westonb/ionophoney/simulation/resonator/testing/test1/84w_1.bmp

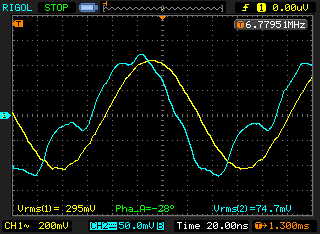
simulation/resonator/testing/test1/84w_1.bmp
