westonb/ionophoney/simulation/resonator/testing/test1/84w_2.bmp

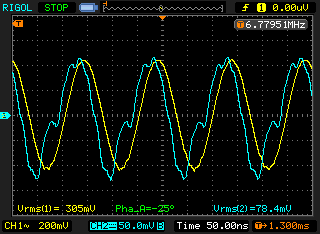
simulation/resonator/testing/test1/84w_2.bmp
