westonb/ionophoney/simulation/resonator/testing/test1/120w_2.bmp

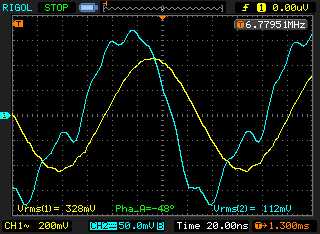
simulation/resonator/testing/test1/120w_2.bmp
