westonb/ionophoney/simulation/resonator/testing/test1/186w_1.bmp

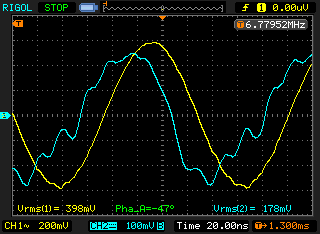
simulation/resonator/testing/test1/186w_1.bmp
