westonb/ionophoney/schematic/class_e.pdf

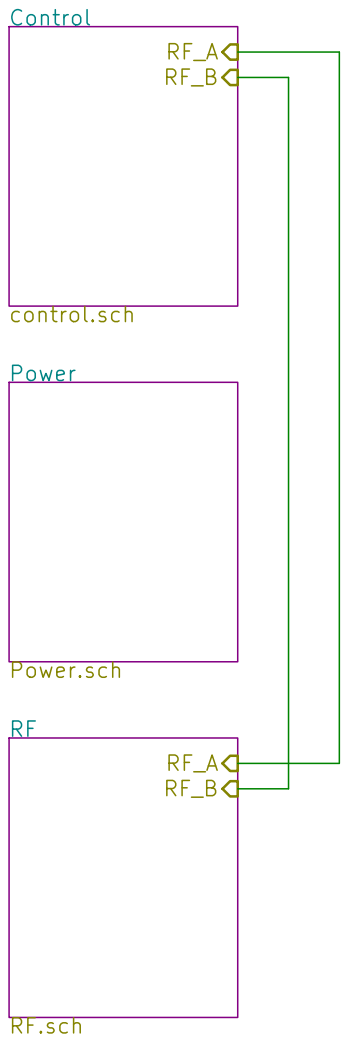
[picture p5: page 1]

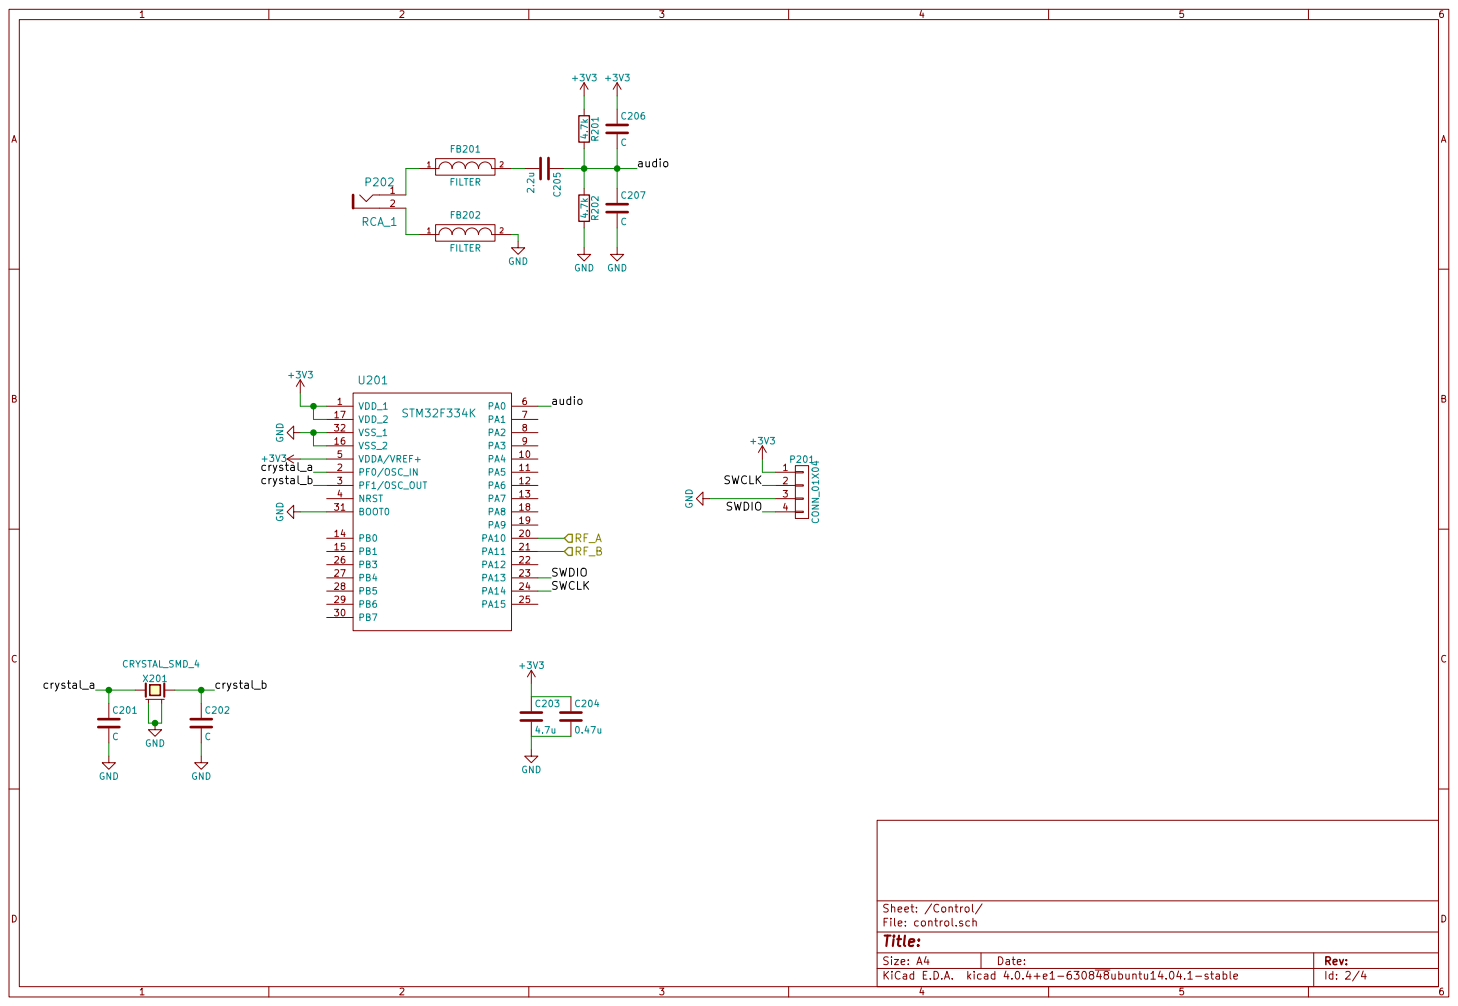
[picture p6: page 2]

Id: 2/4 Title: File: control.sch Sheet: /Control/

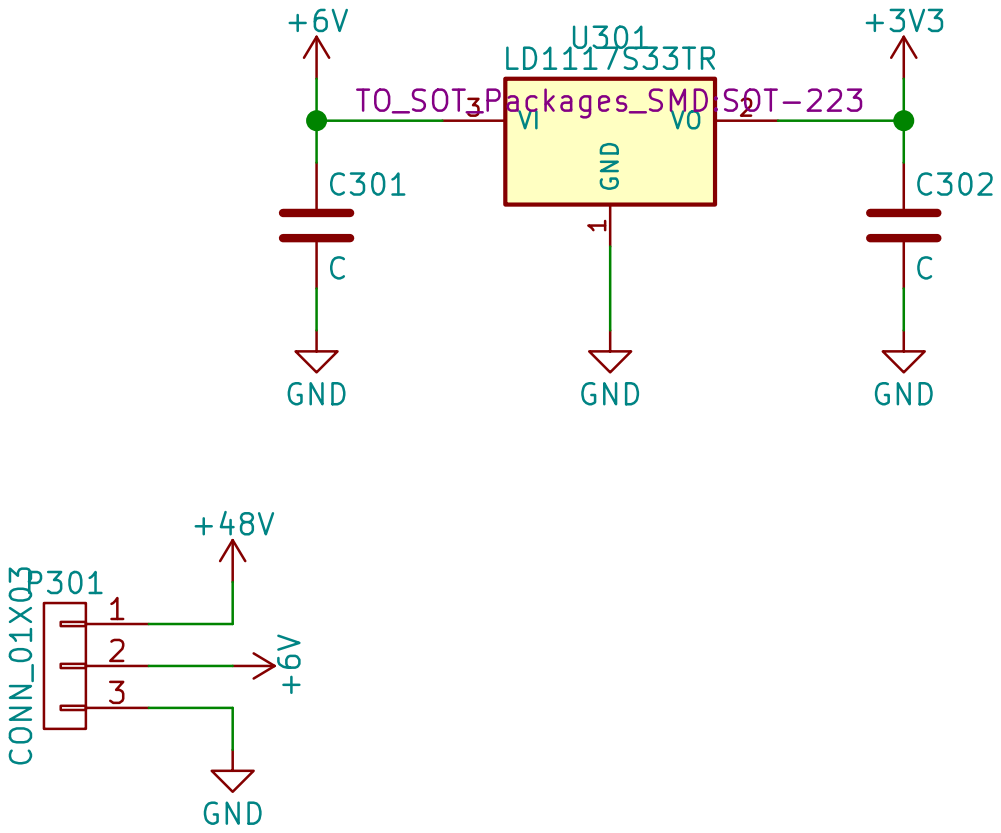
[picture p7: page 3]

Id: 3/4 Title: File: Power.sch Sheet: /Power/ GND

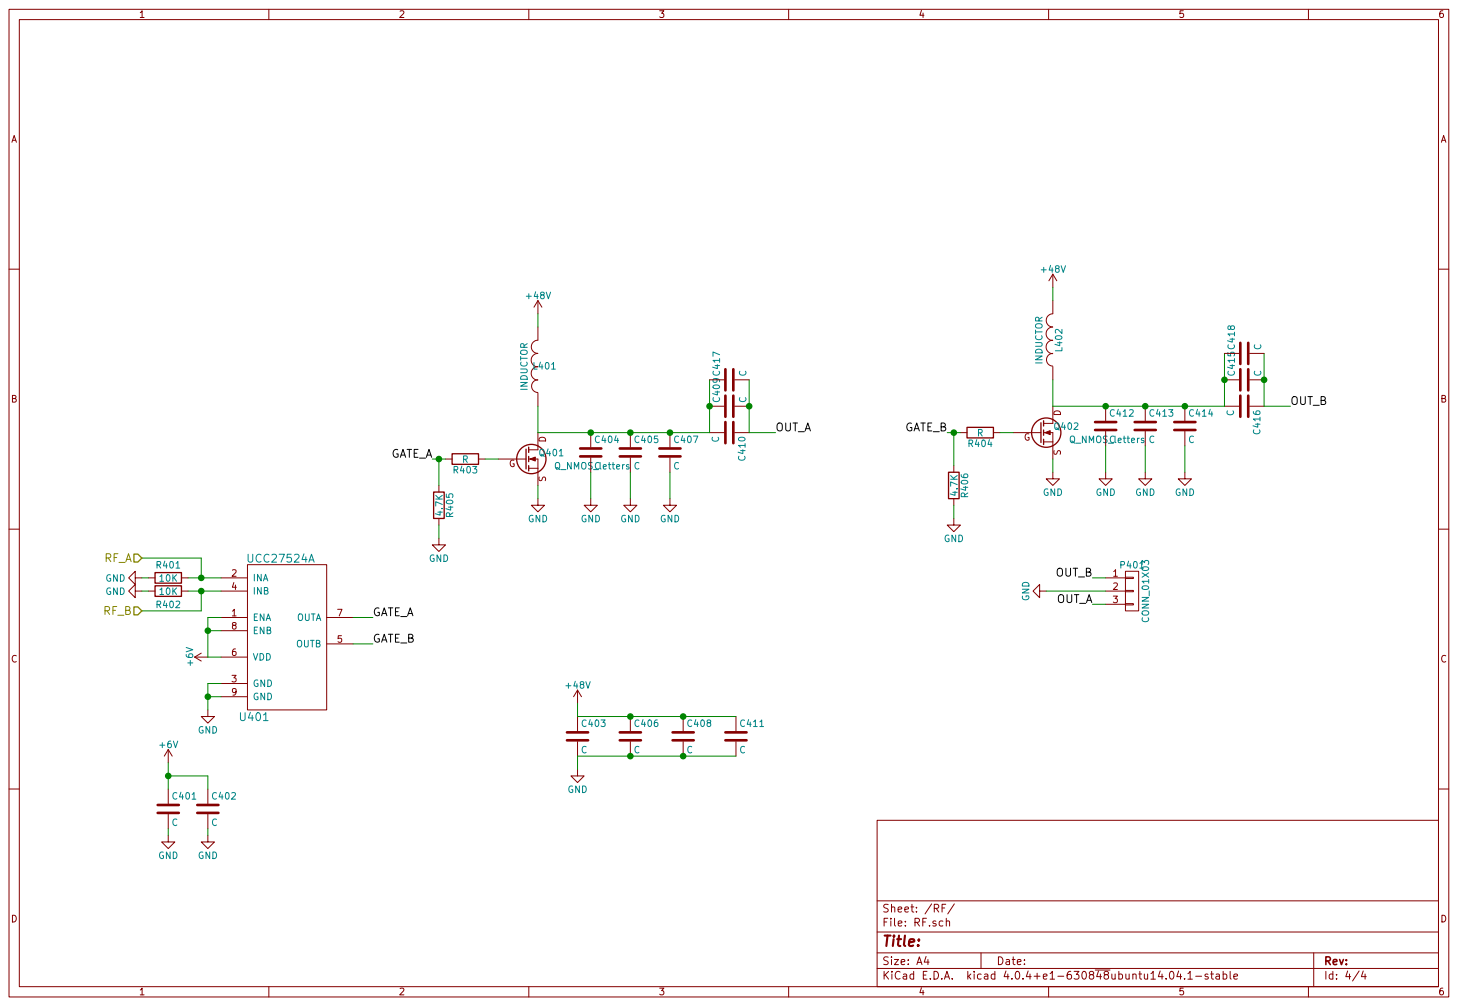
[picture p8: page 4]

Id: 4/4 Title: File: RF.sch Sheet: /RF/
