westonb/ionophoney/simulation/ltspice/class_phi2_paper.asc

C1: cap; 96.5p
C2: cap; 95.7p
C3: cap; 290p
D1: diode; D_ideal
L1: ind; 62.7n
L2: ind; 80n
L3: ind; 357n
R1: res; 25
S1: sw; MYSW
V1: voltage; PULSE(0 10 0 1n 1n 11n 36n)
V2: voltage; 24
Named nets: 0
.model MYSW SW(Ron=30m Roff=1Meg Vt=5 Vh=-.4)
.tran 0 50u 49u
.model D_ideal D(Ron=0.1n Roff=1G Vfwd=0.7)
