westonb/ionophoney/simulation/ltspice/class_DE_bridge_L_test.asc

C1: cap; 1µ
C2: cap; 655p
C3: cap; 1µ
C4: cap; {Cshunt}
C5: cap; {Cshunt}
C6: cap; 0.1µ
C7: cap; {Cshunt}
C8: cap; 0.1µ
C9: cap; {Cshunt}
C10: cap; 0.1µ
D1: schottky; my_SS8PH9
D2: schottky; my_SS8PH9
D3: schottky; my_SS8PH9
D4: schottky; my_SS8PH9
L1: ind; 800n
L2: ind; 220n
R1: res; 6
R2: res; {Rh}
R3: res; {Rh}
R5: res; {Rh}
R6: res; {Rl}
R7: res; {Rl}
R8: res; {Rl}
R9: res; {Rh}
R10: res; {Rl}
U1: GaN_E-HEMT_LT_GS61008P
U2: GaN_E-HEMT_LT_GS61008P
U3: GaN_E-HEMT_LT_GS61008P
U4: GaN_E-HEMT_LT_GS61008P
U5: LM5113_TRANS
U6: LM5113_TRANS
V1: voltage; PULSE(0 {Vg} 0 {Tr} {Tf} {Ton} {Period})
V2: voltage; PULSE(0 {Vg} {Delay} {Tr} {Tf} {Ton} {Period})
V3: voltage; 48; Rser=1m
V4: voltage; PULSE(0 {Vg} 0 {Tr} {Tf} {Ton} {Period})
V5: voltage; PULSE(0 {Vg} {Delay} {Tr} {Tf} {Ton} {Period})
V6: voltage; 5; Rser=0.01
V7: voltage; 48; Rser=1m
V8: voltage; 5; Rser=0.01
Named nets: 0
.param Tf = 5n
.param Tr = 5n
.param Freq = 6.78Meg
.param Period = {1/Freq}
.param Ton = {(Period/2-Tr)*Conduction_Cycle}
.param Toff = {Period/2 }
.param Delay = {Period/2}
.tran 0 3u 2u
.param Conduction_Cycle = 0.75
.param Vg = 5
.param Cshunt = 50p
.param Rh = 0.5
.param Rl = 0.5
