westonb/ionophoney/simulation/ltspice/immittance_converter_test.asc

C1: cap; 1.17n
C2: cap; 1.17n
L1: ind; 470n
L2: ind; 470n
L4: ind; 470n
R1: res; 20
R2: res; 20
R3: res; 20
R4: res; 20
V1: voltage; SINE(0 5 6.78Meg)
V2: voltage; SINE(0 5 6.78Meg)
Named nets: 0
.tran 0 10u 9u
