westonb/ionophoney/simulation/ltspice/class_DE_bridge_benchmark.asc

C1: cap; 1µ
C2: cap; 600p
C3: cap; 1µ
C4: cap; {Cshunt}
C5: cap; {Cshunt}
C6: cap; {Cshunt}
C7: cap; {Cshunt}
D1: schottky; MBR20100CT
D2: schottky; MBR20100CT
D3: schottky; MBR20100CT
D4: schottky; MBR20100CT
L1: ind; 0.94µ
R1: res; 2
R2: res; 1
R3: res; 1
R4: res; 1
R5: res; 1
U1: GaN_E-HEMT_LT_GS61008P
U2: GaN_E-HEMT_LT_GS61008P
U3: GaN_E-HEMT_LT_GS61008P
U4: GaN_E-HEMT_LT_GS61008P
V1: voltage; PULSE(0 {Vg} 0 {Tr} {Tf} {Ton} {Period})
V2: voltage; PULSE(0 {Vg} {Delay} {Tr} {Tf} {Ton} {Period})
V3: voltage; 48; Rser=1m
V4: voltage; PULSE(0 {Vg} {Delay} {Tr} {Tf} {Ton} {Period})
V5: voltage; PULSE(0 {Vg} 0 {Tr} {Tf} {Ton} {Period})
Named nets: 0
.param Tf = 5n
.param Tr = 5n
.param Freq = 6.78Meg
.param Period = {1/Freq}
.param Ton = {(Period/2-Tr)*Conduction_Cycle}
.param Toff = {Period/2 }
.param Delay = {Period/2}
.tran 0 10u 9u
.param Conduction_Cycle = 0.85
.param Vg = 5
.param Cshunt = 200p
