westonb/ionophoney/simulation/ltspice/class_E_modified.asc

C1: cap; 900p
C2: cap; 1.5µ
C3: cap; {223p/2}
L1: ind; 360n
L2: ind; 4n
L3: ind; {2*2.79E-6}
R1: res; 0.5
R2: res; 8
U2: GaN_E-HEMT_LT_GS66508T
V1: voltage; PULSE(0 {Vg} 0 {Tr} {Tf} {Ton} {Period})
V2: voltage; 48
Named nets: 0
.param Tf = 5n
.param Tr = 5n
.param Freq = 6.78Meg
.param Period = {1/Freq}
.param Ton = {(Period/2-Tr)*Conduction_Cycle}
.param Toff = {Period/2 }
.tran 0 10u 9u
.param Conduction_Cycle = 1
.param Vg = 6
.step param RLOAD list 6 8 10 16 22 36 45 58 80
.param RLOAD 16
.param phaseShift = 0.5*{Period} + 0.5*0.001*{Period}
Resonator Parameters from Testing (assuming Q of 5)
