westonb/ionophoney/simulation/ltspice/class_phi2_modified.asc

C1: cap; 700p
C2: cap; 1µ
C3: cap; 223p
C4: cap; {CMR}
C5: cap; 0.1p
L1: ind; 800n
L2: ind; 1n
L3: ind; 2.47E-6
L4: ind; {LMR}
R1: res; 0.5
R2: res; {RLOAD}
R3: res; 6
U2: GaN_E-HEMT_LT_GS66508T
V1: voltage; PULSE(0 {Vg} 0 {Tr} {Tf} {Ton} {Period})
V2: voltage; 170
Named nets: 0, THERM
.param Tf = 5n
.param Tr = 5n
.param Freq = 6.78Meg
.param Period = {1/Freq}
.param Ton = {(Period/2-Tr)*Conduction_Cycle}
.param Toff = {Period/2 }
.tran 0 10u 9u
.param Conduction_Cycle = 0.6
.param Vg = 6
.step param RLOAD list 6 8 10 16 22 36
.param RLOAD 20
.param phaseShift = 0.5*{Period} + 0.5*0.001*{Period}
Resonator Parameters from Testing (assuming Q of 5): 223p, 2.79u, 16
.param Z 3
.param LMR 800n
.param CMR {  (1/(2*2*3.14*6.78E6))^2/{LMR} - 100p }
