westonb/ionophoney/simulation/ltspice/class_E_modified_outphase.asc

C1: cap; 20p
C2: cap; 1.5n
C3: cap; 223p
C4: cap; 20p
C5: cap; 1.5n
C6: cap; 223p
C7: cap; 100µ; Rser=0.01m Lser=0.1n
C8: cap; 100µ; Rser=0.01m Lser=0.1n
D1: diode; Didl
D2: diode; Didl
L1: ind; 500n
L2: ind; 400n
L3: ind; 2.79E-6
L4: ind; 500n
L5: ind; 400n
L6: ind; 2.79E-6
R1: res; 0.5
R2: res; 50
R3: res; 0.5
R4: res; 20
U1: GaN_E-HEMT_LT_GS66508T
U2: GaN_E-HEMT_LT_GS66508T
V1: voltage; PULSE(0 {Vg} 0 {Tr} {Tf} {Ton} {Period})
V2: voltage; 80; Rser=1000m
V3: voltage; PULSE(0 {Vg} {phaseShift} {Tr} {Tf} {Ton} {Period})
V4: voltage; 80; Rser=1000m
V5: voltage; 250
V6: voltage; 250
Named nets: 0
.param Tf = 5n
.param Tr = 5n
.param Freq = 6.78Meg
.param Period = {1/Freq}
.param Ton = {(Period/2-Tr)*Conduction_Cycle}
.param Toff = {Period/2 }
.tran 0 10u 9u
.param Conduction_Cycle = 1
.param Vg = 6
.step param RLOAD list 6 8 10 16 22 36 45 58 80
.param RLOAD 16
.param phaseShift = {{phaseShifted}*{Period}}
Resonator Parameters from Testing (assuming Q of 5)
.step param phaseShifted list 0.1 0.3 0.5
.param phaseShifted = 0.5
.model Didl D(Ron=0.1 Roff=1G Vfwd=0)
