westonb/ionophoney/simulation/ltspice/coil_model.asc

C1: cap; 18p
C2: cap; 600p
L1: ind2; 1µ
L2: ind2; 30µ; Rser=0.001m
R1: res; 20
R2: res; 1
V1: voltage; AC 1
Named nets: 0
.ac oct 500 5Meg 9Meg
K1 L1 L2 0.19
