westonb/ionophoney/simulation/ltspice/Draft1.asc

C1: cap; 100p
C2: cap; 40p
C3: cap; 18.8p
C5: cap; 4n
C6: cap; 1p
L1: ind; 270n
L2: ind; 375n
L3: ind; 198.8n
L4: ind; 1n
R1: res; 33.3
R2: res; 1m
R3: res; 1m
V1: voltage; AC 1
Named nets: 0
.ac oct 100 15Meg 100Meg
