westonb/ionophoney/simulation/ltspice/class_DE_simple.asc

C1: cap; 1µ
C2: cap; 600p
C3: cap; 0.1µ
C4: cap; 200p
C5: cap; 200p
D1: schottky; MBR20100CT
D2: schottky; MBR20100CT
L1: ind; 0.93µ
R1: res; 1
R2: res; 2
R3: res; 2
U1: GaN_E-HEMT_LT_GS61008P
U2: GaN_E-HEMT_LT_GS61008P
V1: voltage; PULSE(0 {Vg} 0 {Tr} {Tf} {Ton} {Period})
V2: voltage; PULSE(0 {Vg} {Delay} {Tr} {Tf} {Ton} {Period})
V3: voltage; 48; Rser=0.1
V4: voltage; 24; Rser=0.1
Named nets: 0
.param Tf = 5n
.param Tr = 5n
.param Freq = 6.78Meg
.param Period = {1/Freq}
.param Ton = {(Period/2-Tr)*Conduction_Cycle}
.param Toff = {Period/2 }
.param Delay = {Period/2}
.tran 0 10u 9u
.param Conduction_Cycle = 0.85
.param Vg = 5
