westonb/ionophoney/class_e/pcb/class_e.kicad_pcb

## KiCad design class_e/pcb/class_e.kicad_pcb (2016-11-27)

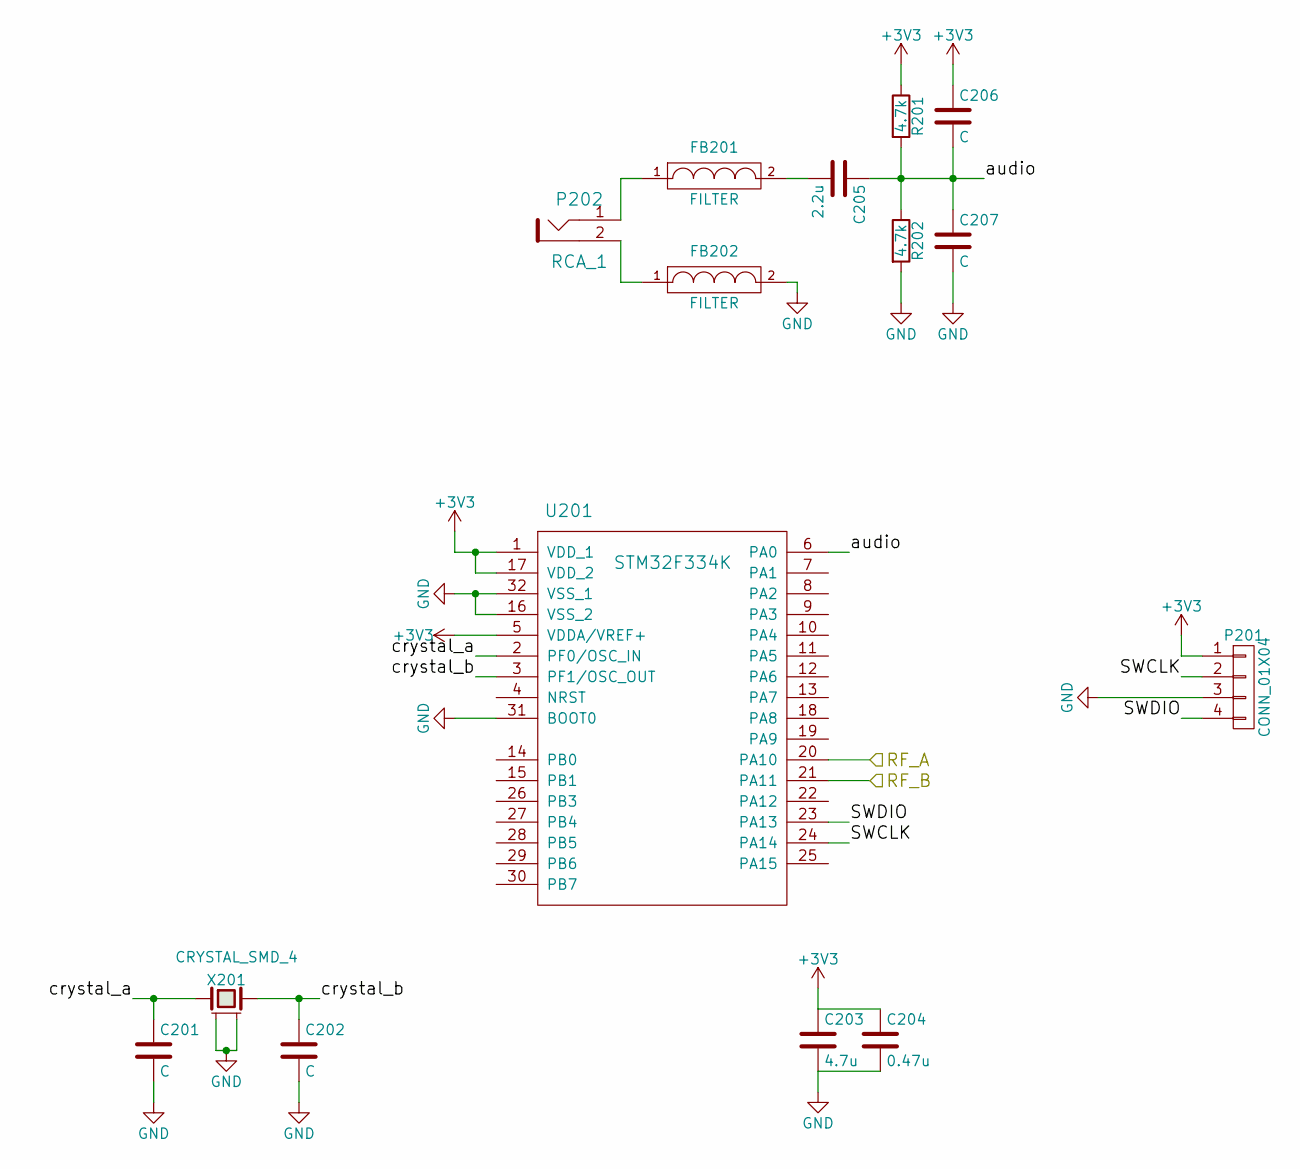
[picture p9: schematic control.sch]

Parts:
C201, C202, C206, C207: C; C_0603
C203: 4.7u; C_0603
C204: 0.47u; C_0603
C205: 2.2u; C_0603
FB201, FB202: FILTER; C_0805
P201: CONN_01X04; Pin_Header_Straight_1x04
P202: RCA_1; RCA
R201, R202: 4.7k; R_0603
U201: STM32F334K; LQFP-32_7x7mm_Pitch0.8mm
X201: CRYSTAL_SMD_4; Crystal_3.2x2.5

Connections:
+3V3: C203.1, C204.1, C206.1, P201.1, R201.1, U201.1 (VDD_1), U201.5 (VDDA/VREF+), U201.17 (VDD_2); also elsewhere on the board
/Control/RF_A: U201.20 (PA10); also elsewhere on the board
/Control/RF_B: U201.21 (PA11); also elsewhere on the board
/Control/SWCLK: P201.2, U201.24 (PA14)
/Control/SWDIO: P201.4, U201.23 (PA13)
/Control/audio: C205.1, C206.2, C207.1, R201.2, R202.1, U201.6 (PA0)
/Control/crystal_a: C201.1, U201.2 (PF0/OSC_IN), X201.1
/Control/crystal_b: C202.1, U201.3 (PF1/OSC_OUT), X201.3
GND: C201.2, C202.2, C203.2, C204.2, C207.2, FB202.2, P201.3, R202.2, U201.16 (VSS_2), U201.31 (BOOT0), U201.32 (VSS_1), X201.2, X201.4; also elsewhere on the board
unnamed: C205.2, FB201.2
unnamed: FB201.1, P202.1
unnamed: FB202.1, P202.2

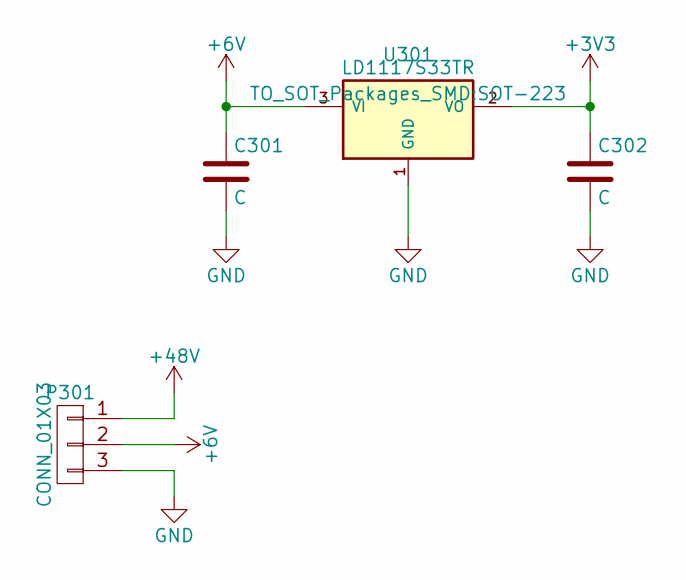
[picture p10: schematic Power.sch]

Parts:
C301, C302: C; C_0603
P301: CONN_01X03; terminalBlock-3.5mm-3
U301: LD1117S33TR; SOT-223

Connections:
+3V3: C302.1, U301.2 (VO); also elsewhere on the board
+6V: C301.1, P301.2, U301.3 (VI); also elsewhere on the board
+48V: P301.1; also elsewhere on the board
GND: C301.2, C302.2, P301.3, U301.1 (GND); also elsewhere on the board

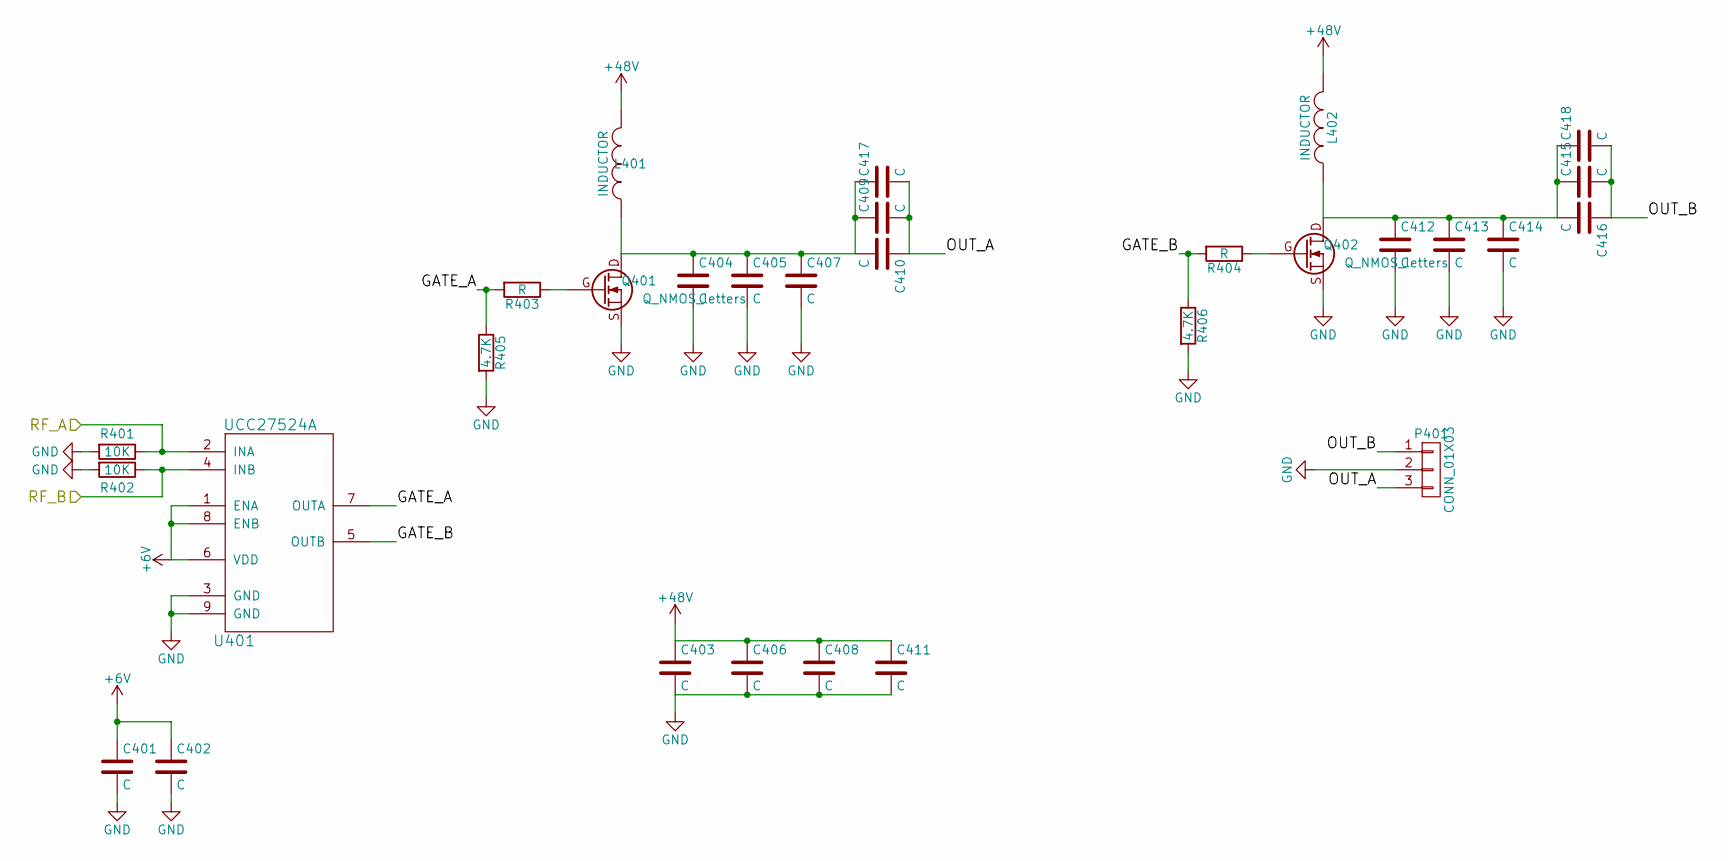
[picture p11: schematic RF.sch]

Parts:
C401, C402: C; C_0603
C403, C404, C405, C406, C407, C408, C409, C410, C411, C412, C413, C414, C415, C416, C417, C418: C; C_1206
L401, L402: INDUCTOR; 2929SQ
P401: CONN_01X03; terminalBlock-3.5mm-3
Q401, Q402: Q_NMOS_letters; GS66508T
R401, R402: 10K; R_0603
R403, R404: R; R_0805
R405, R406: 4.7K; R_0603
U401: UCC27524A; SOIC-8-1EP_3.9x4.9mm_Pitch1.27mm

Connections:
+6V: C401.1, C402.1, U401.1 (ENA), U401.6 (VDD), U401.8 (ENB); also elsewhere on the board
+48V: C403.1, C406.1, C408.1, C411.1, L401.2, L402.2; also elsewhere on the board
/Control/RF_A: R401.1, U401.2 (INA); also elsewhere on the board
/Control/RF_B: R402.1, U401.4 (INB); also elsewhere on the board
/RF/GATE_A: R403.2, R405.1, U401.7 (OUTA)
/RF/GATE_B: R404.2, R406.1, U401.5 (OUTB)
/RF/OUT_A: C409.2, C410.1, C417.2, P401.3
/RF/OUT_B: C415.2, C416.1, C418.2, P401.1
GND: C401.2, C402.2, C403.2, C404.2, C405.2, C406.2, C407.2, C408.2, C411.2, C412.2, C413.2, C414.2, P401.2, Q401.S, Q402.S, R401.2, R402.2, R405.2, R406.2, U401.3 (GND), U401.9 (GND); also elsewhere on the board
unnamed: C404.1, C405.1, C407.1, C409.1, C410.2, C417.1, L401.1, Q401.D
unnamed: C412.1, C413.1, C414.1, C415.1, C416.2, C418.1, L402.1, Q402.D
unnamed: Q401.G, R403.1
unnamed: Q402.G, R404.1

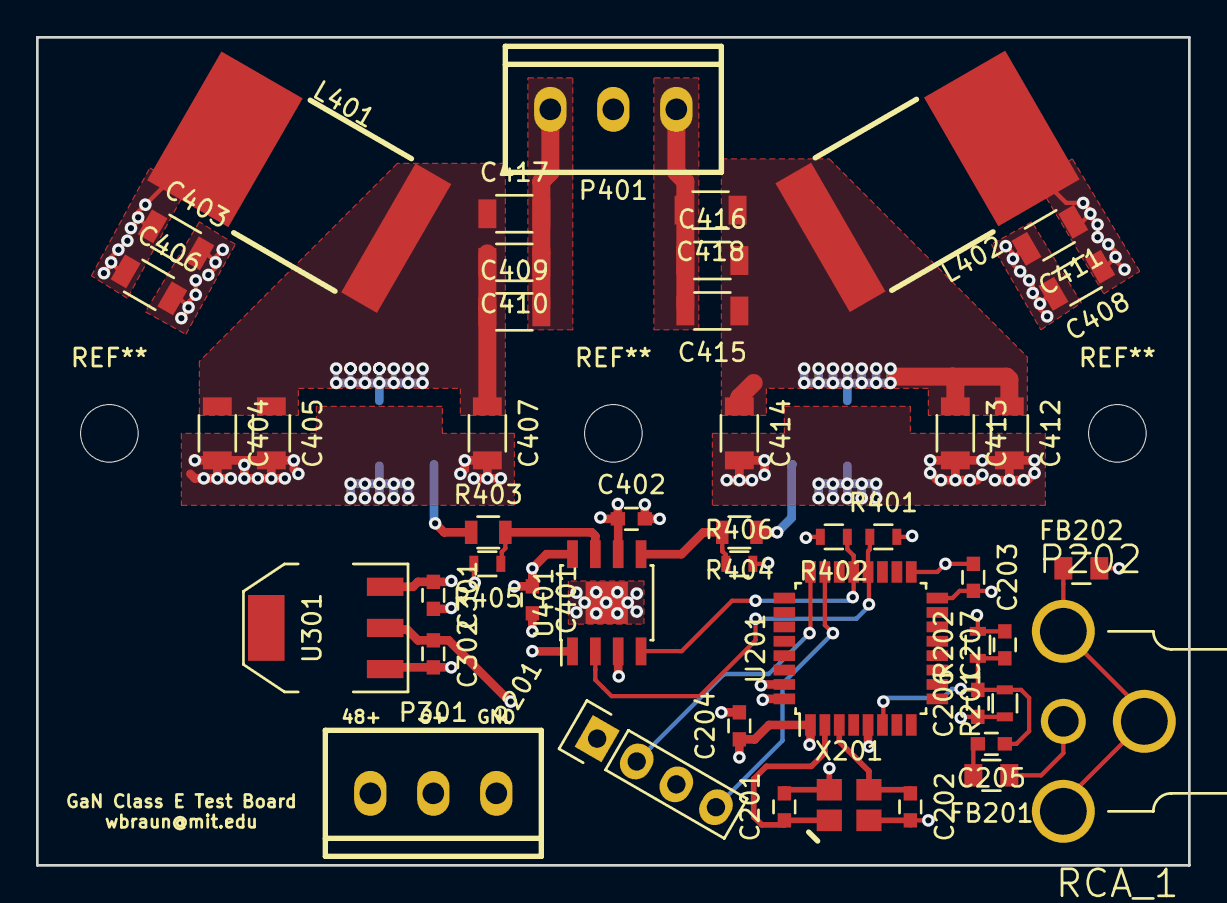
[picture p12: board class_e.kicad_pcb from above]

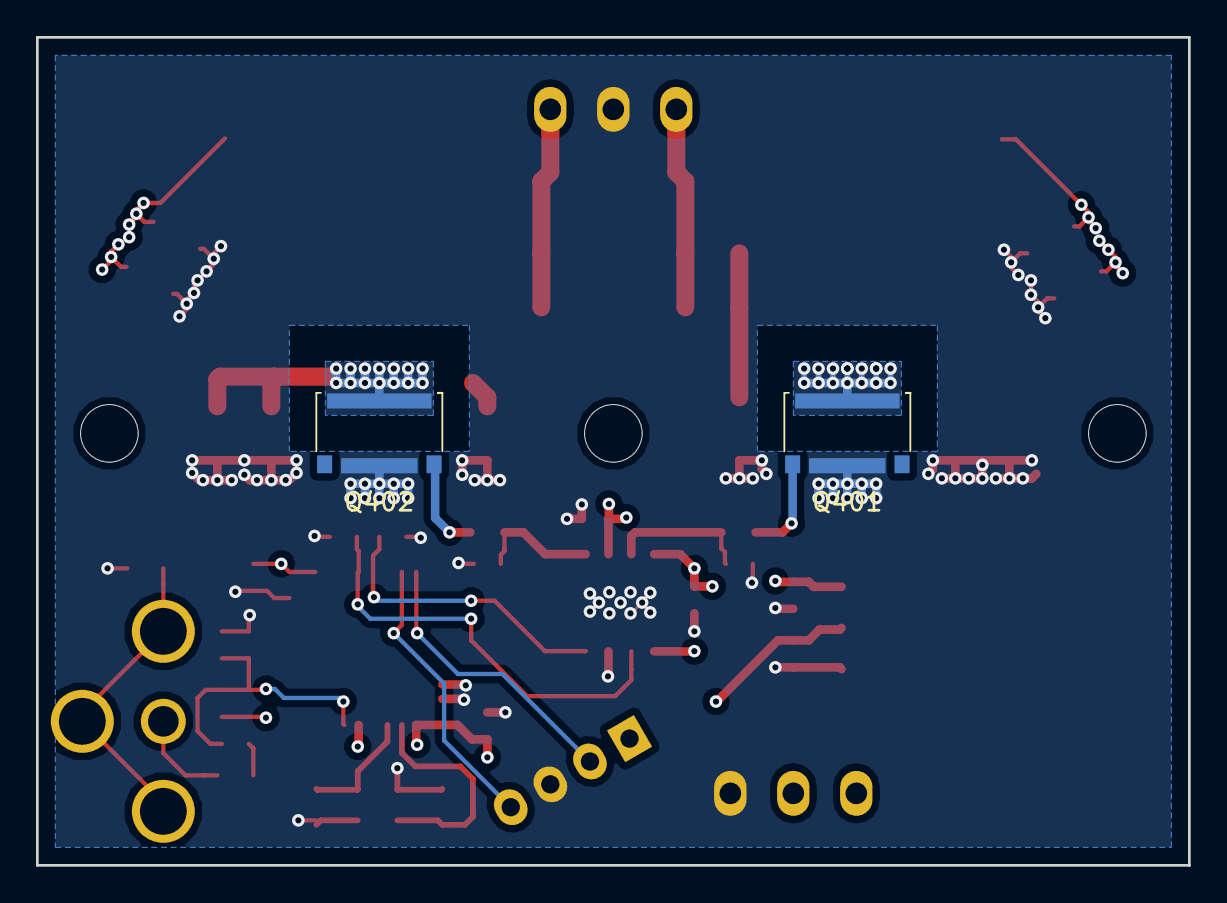
[picture p13: board class_e.kicad_pcb from below]

Board: 4 copper layers, 64.0 x 46.0 mm, 49 parts (2 on the bottom side), 22 nets.
