westonb/ionophoney/(commit log)

2016-04-06 First commit! Schematic topology entered
    [control.sch, ionophoney.kicad_pcb, ionophoney.sch, measurement.sch, output_network.sch, power_supply.sch, rf.sch]
2016-04-08 added measurements and simulation
    [ionophoney.sch, measurement.sch, rf.sch]
2016-11-27 new GaN test board
    [Power.sch, RF.sch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]
2016-11-27 slight pcb changes, sent off to fab
    [class_e-B.Cu.gbl, class_e-B.Mask.gbs, class_e-B.SilkS.gbo, class_e-Edge.Cuts.gm1, class_e-F.Cu.gtl, class_e-F.Mask.gts, class_e-F.SilkS.gto, class_e.drl]
2017-01-12 pwm works
